brickxter/smartersilo.pcb/kicad-libs/3dmodels/E73-2G4M08S1C.step

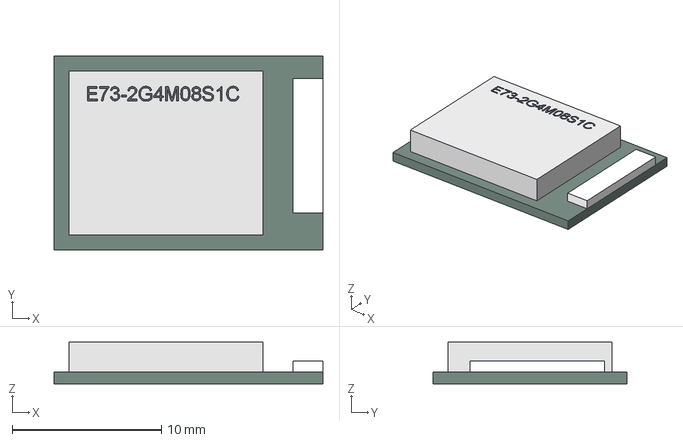
[picture p1: CAD file, 2024-12-10]
kicad-libs/3dmodels/E73-2G4M08S1C.step
18.0 x 13.0 x 2.81 mm
