brickxter/smartersilo.pcb/main-nrf52-e73/v1/main-nrf52-e73.pdf

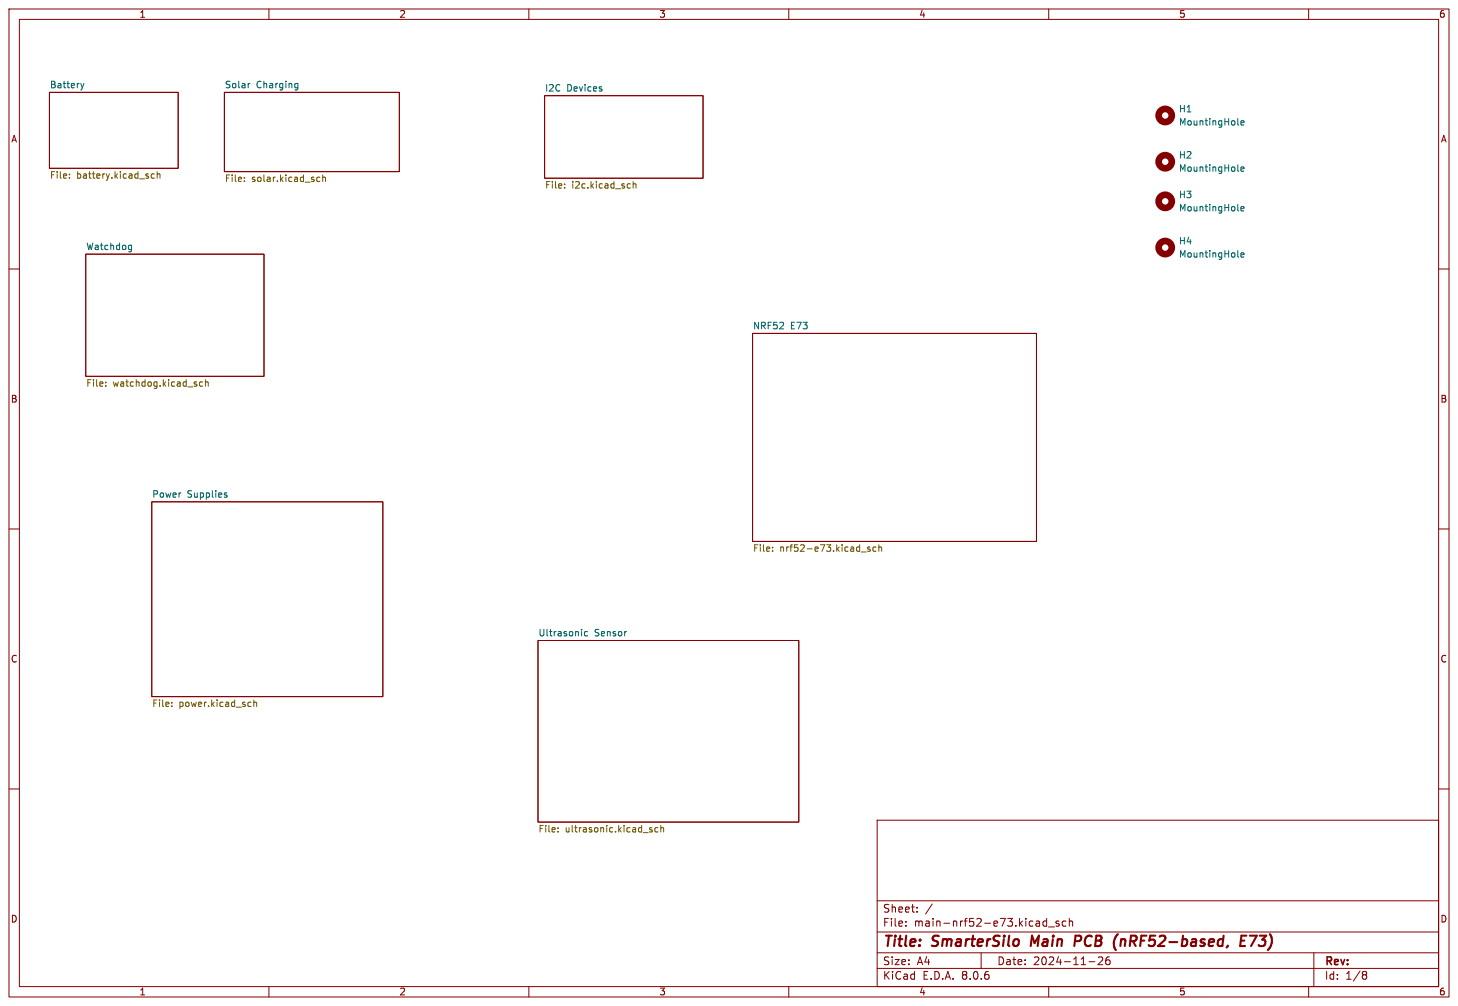
[picture p2: page 1]

Solar Charging File: solar.kicad_sch Battery File: battery.kicad_sch

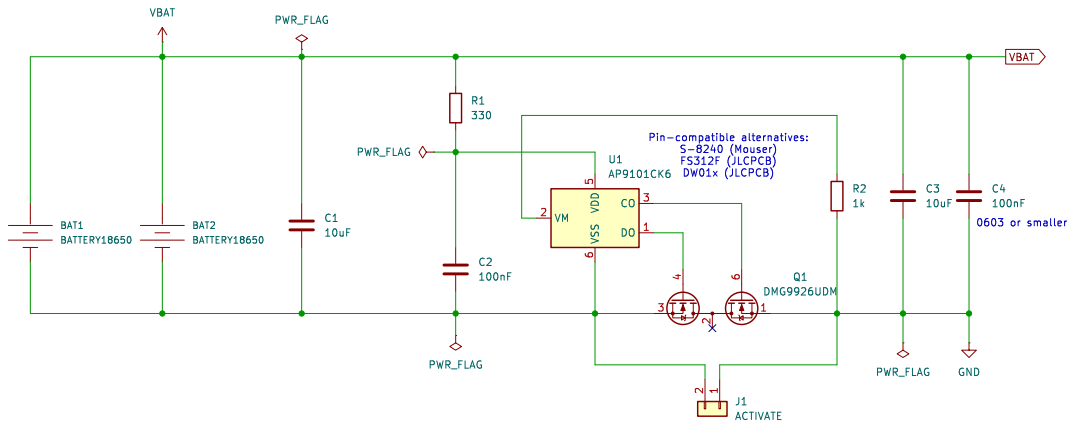
[picture p3: page 2]

Id: 2/8 Title: File: battery.kicad_sch Sheet: /Battery/

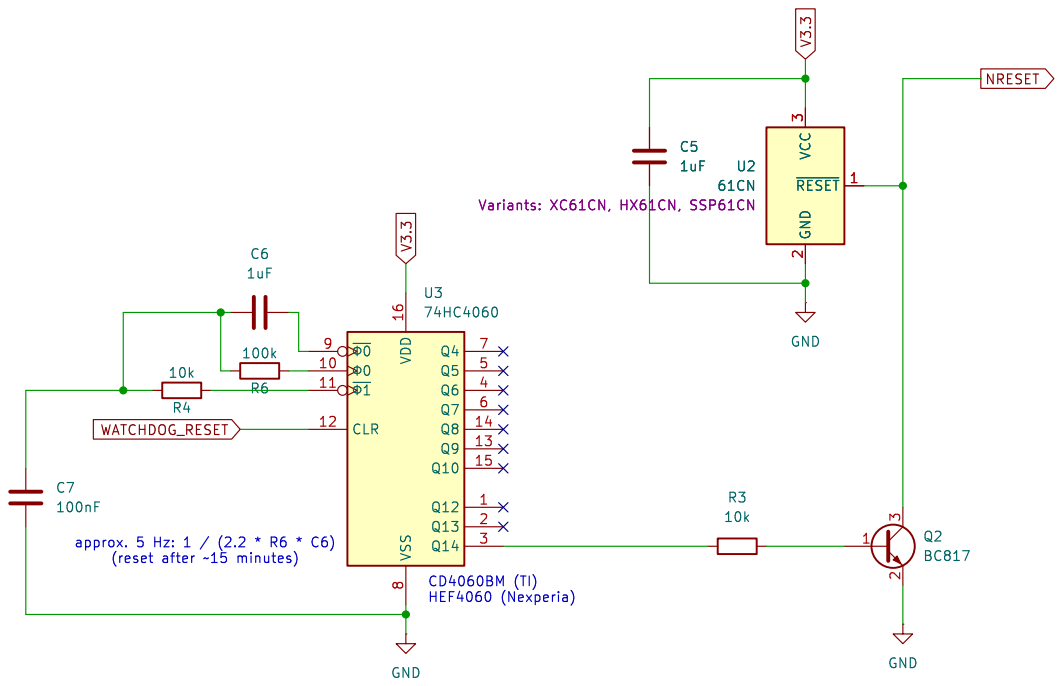
[picture p4: page 3]

File: watchdog.kicad_sch Sheet: /Watchdog/
Id: 3/8 Title: Watchdog Circuits and Voltage Monitoring

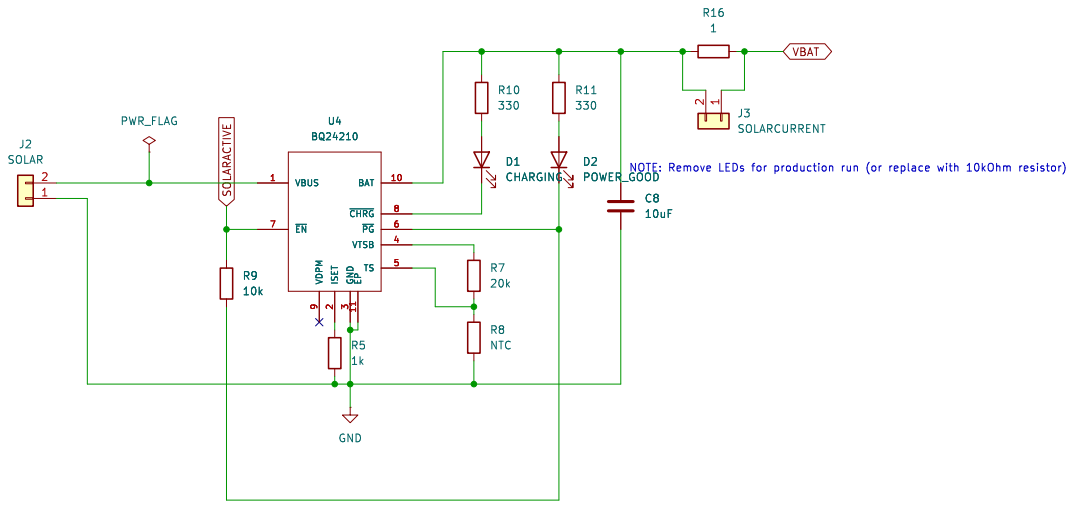
[picture p5: page 4]

3 VTSB 4 TS 5 ~{PG} 6 ~{EN} 7 ~{CHRG} 8 VDPM

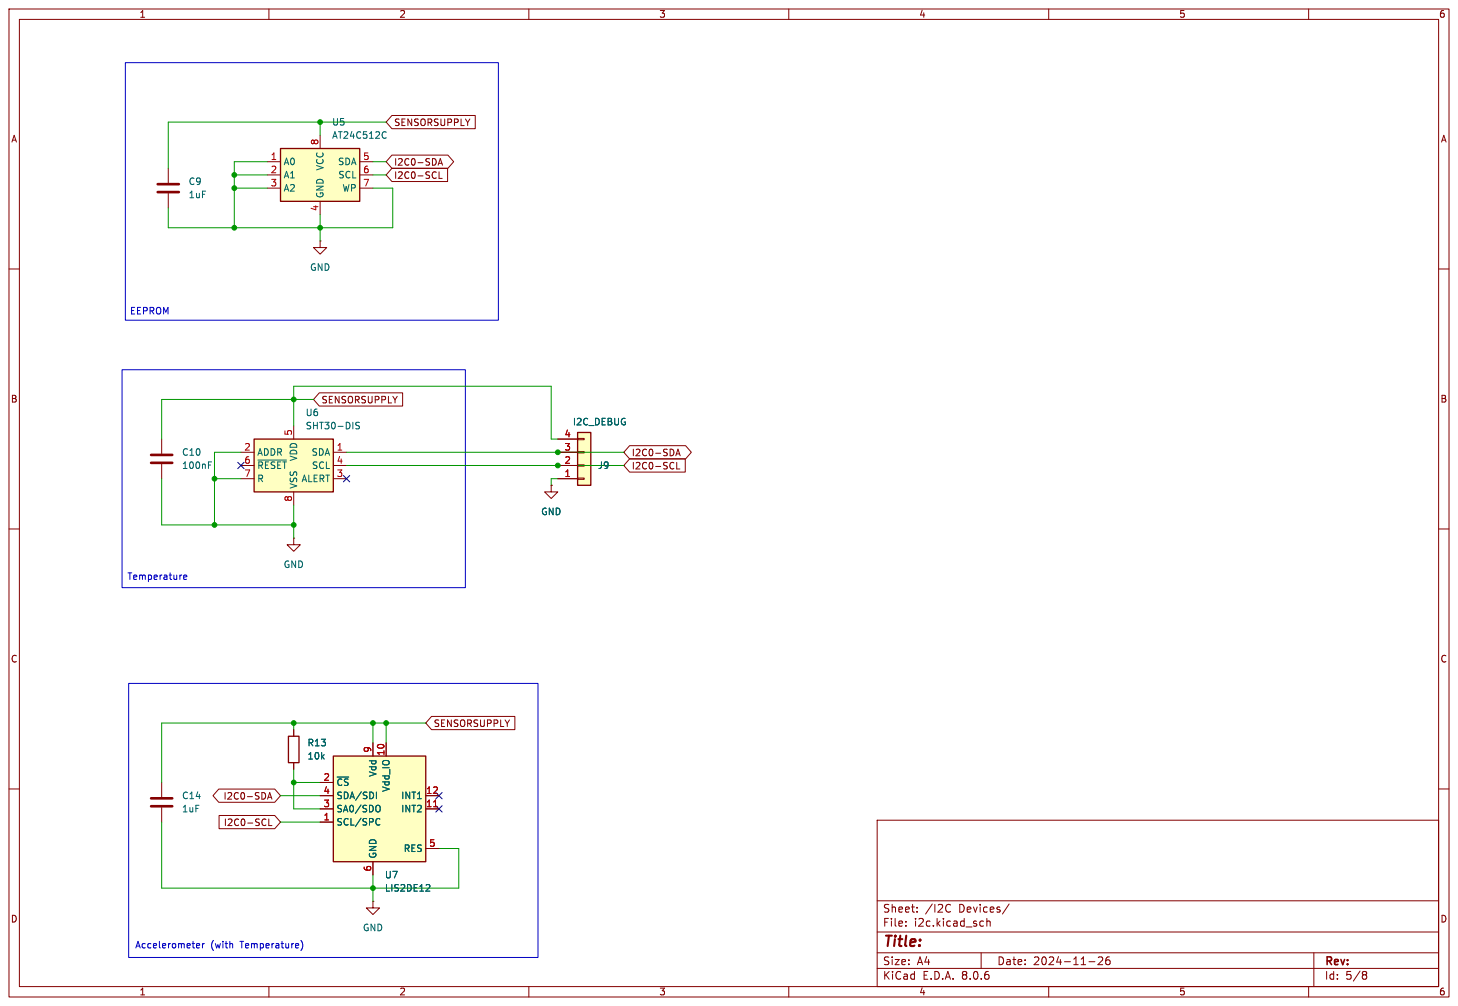
[picture p6: page 5]

4 SDA 5 SCL 6 WP 7 VCC

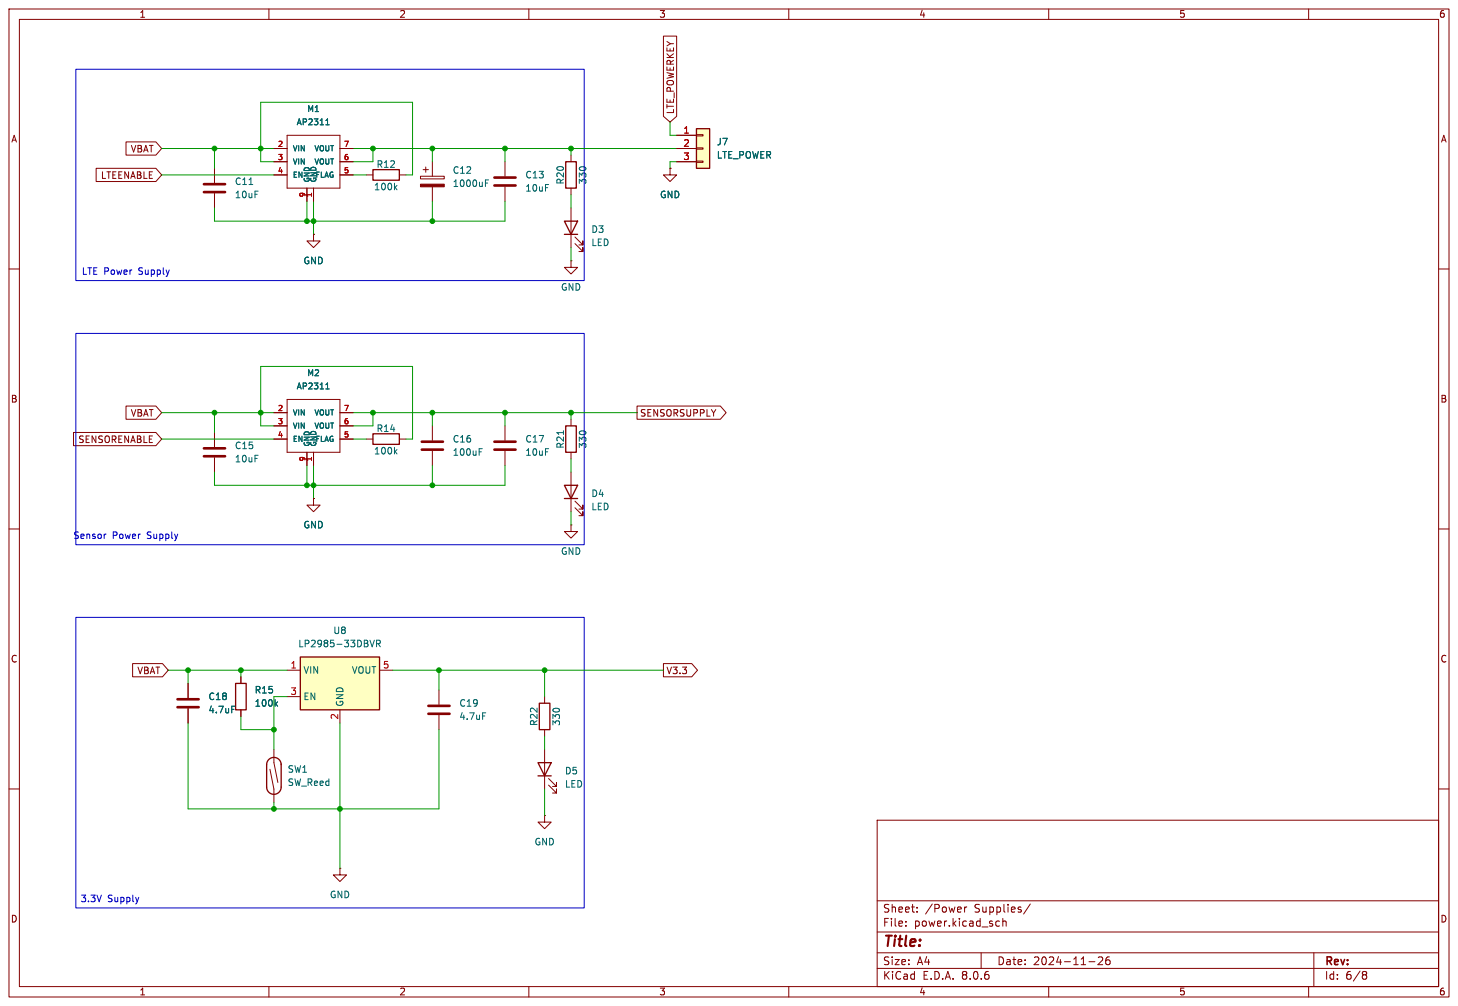
[picture p7: page 6]

1 VIN 2 VIN 3 EN 4 FLAG 5 VOUT 6 VOUT 7 GND
LTE_POWER GND GND
3 GND GND M2 AP2311GND
100k GND
1000uF GND

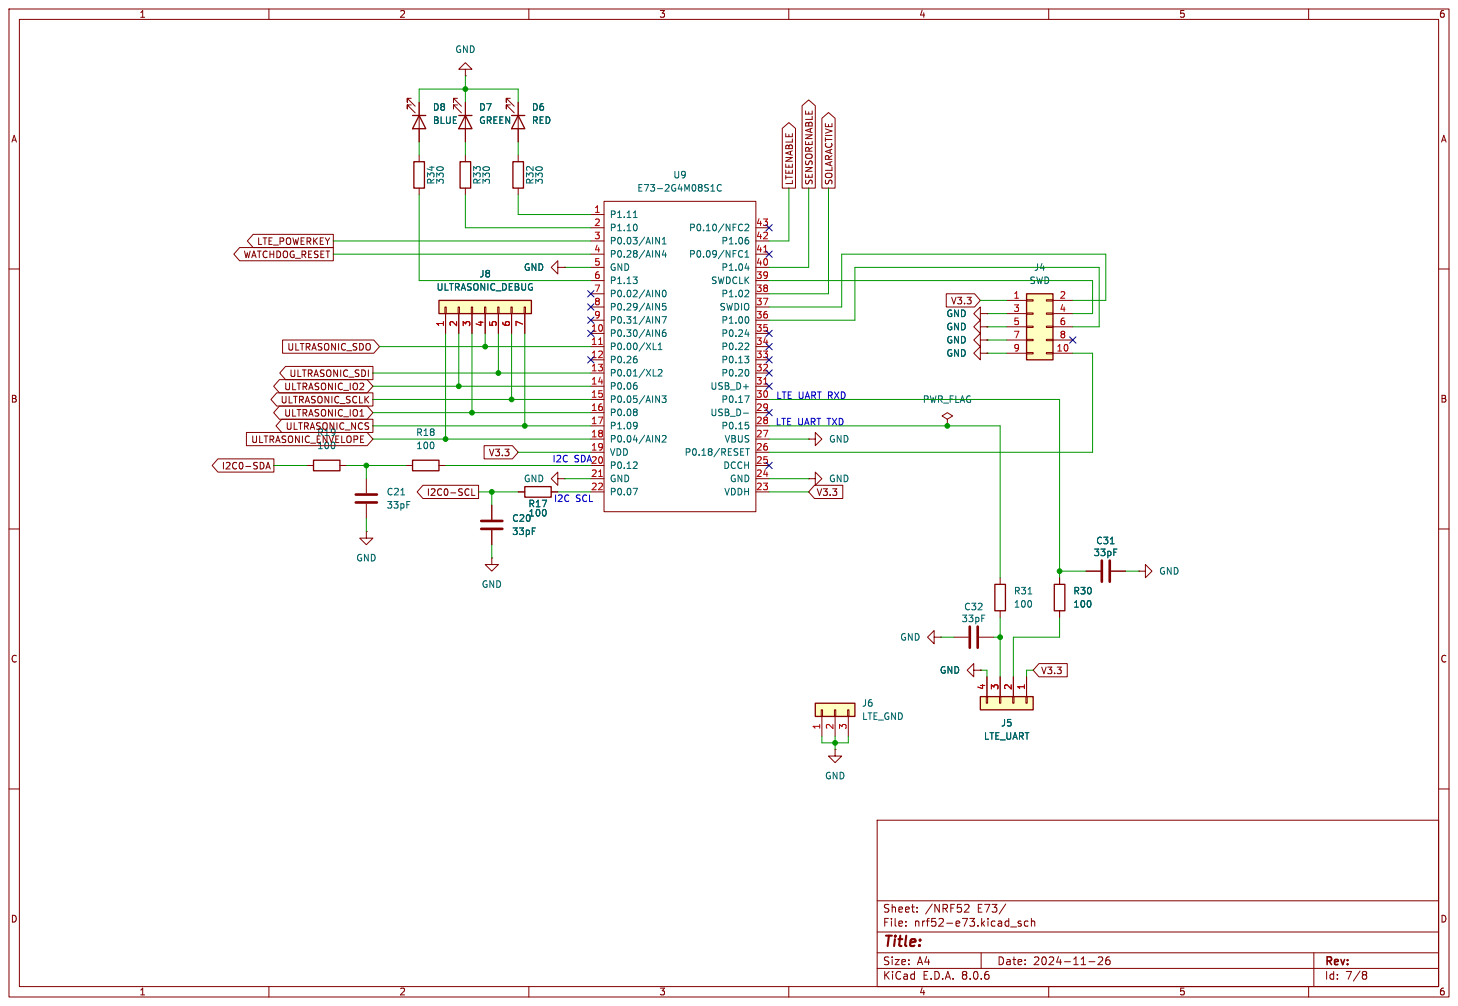
[picture p8: page 7]

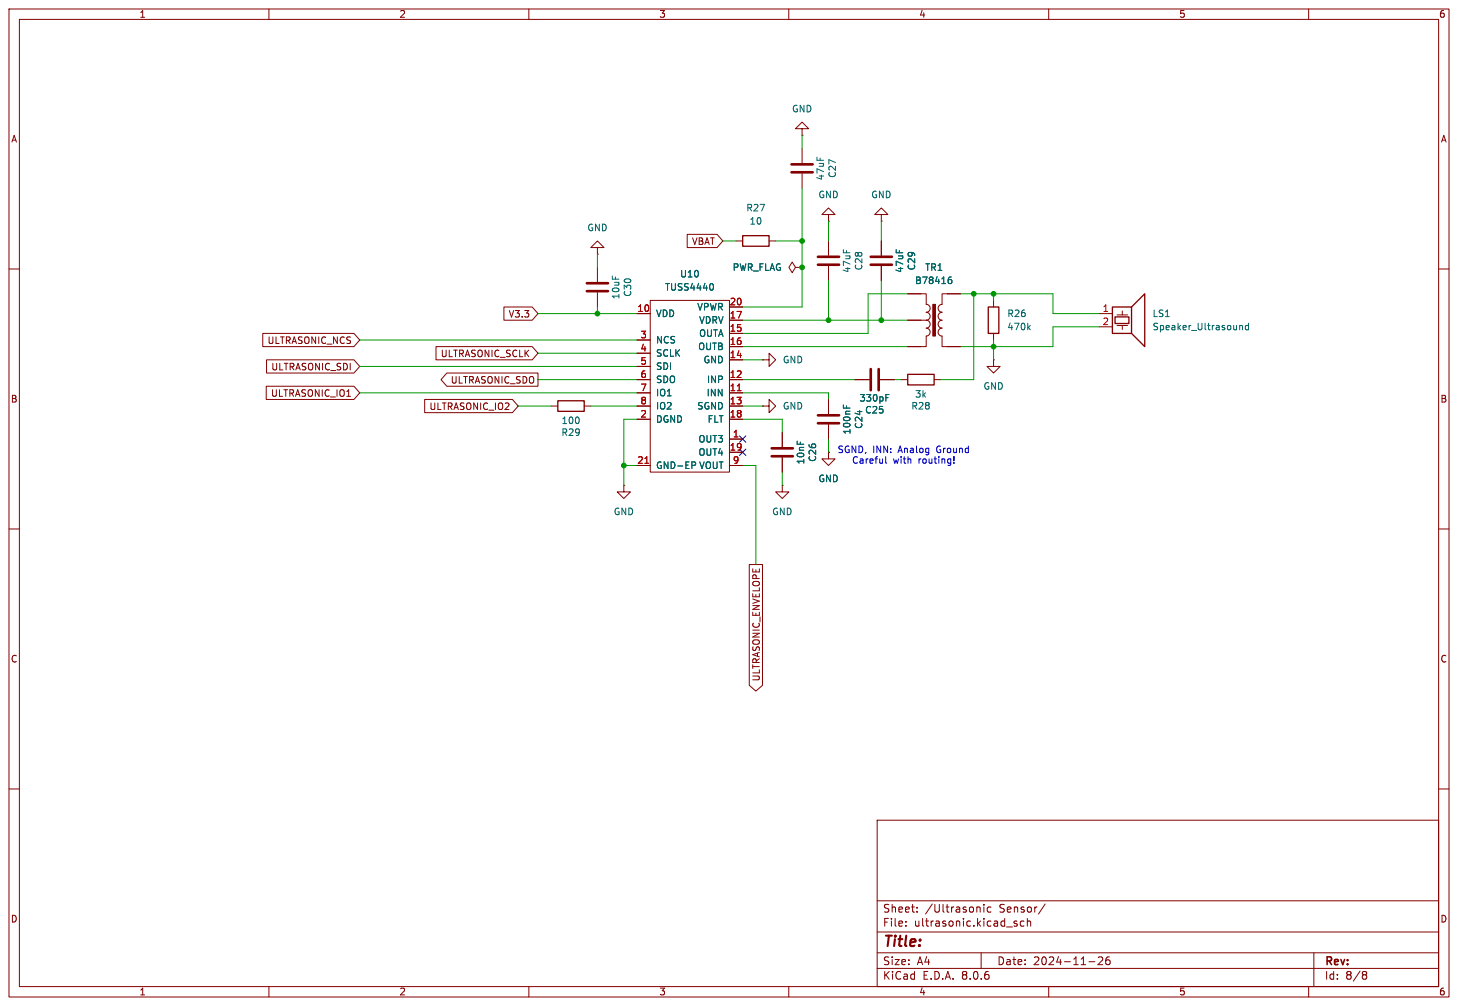
[picture p9: page 8]

SGND, INN: Analog Ground Careful with routing! TR1 B78416 GND 10nF C26 PWR_FLAG
