brickxter/smartersilo.pcb/main-nrf52-e73/main-nrf52-e73.kicad_pcb

## KiCad design main-nrf52-e73/main-nrf52-e73.kicad_pcb (2024-12-10)

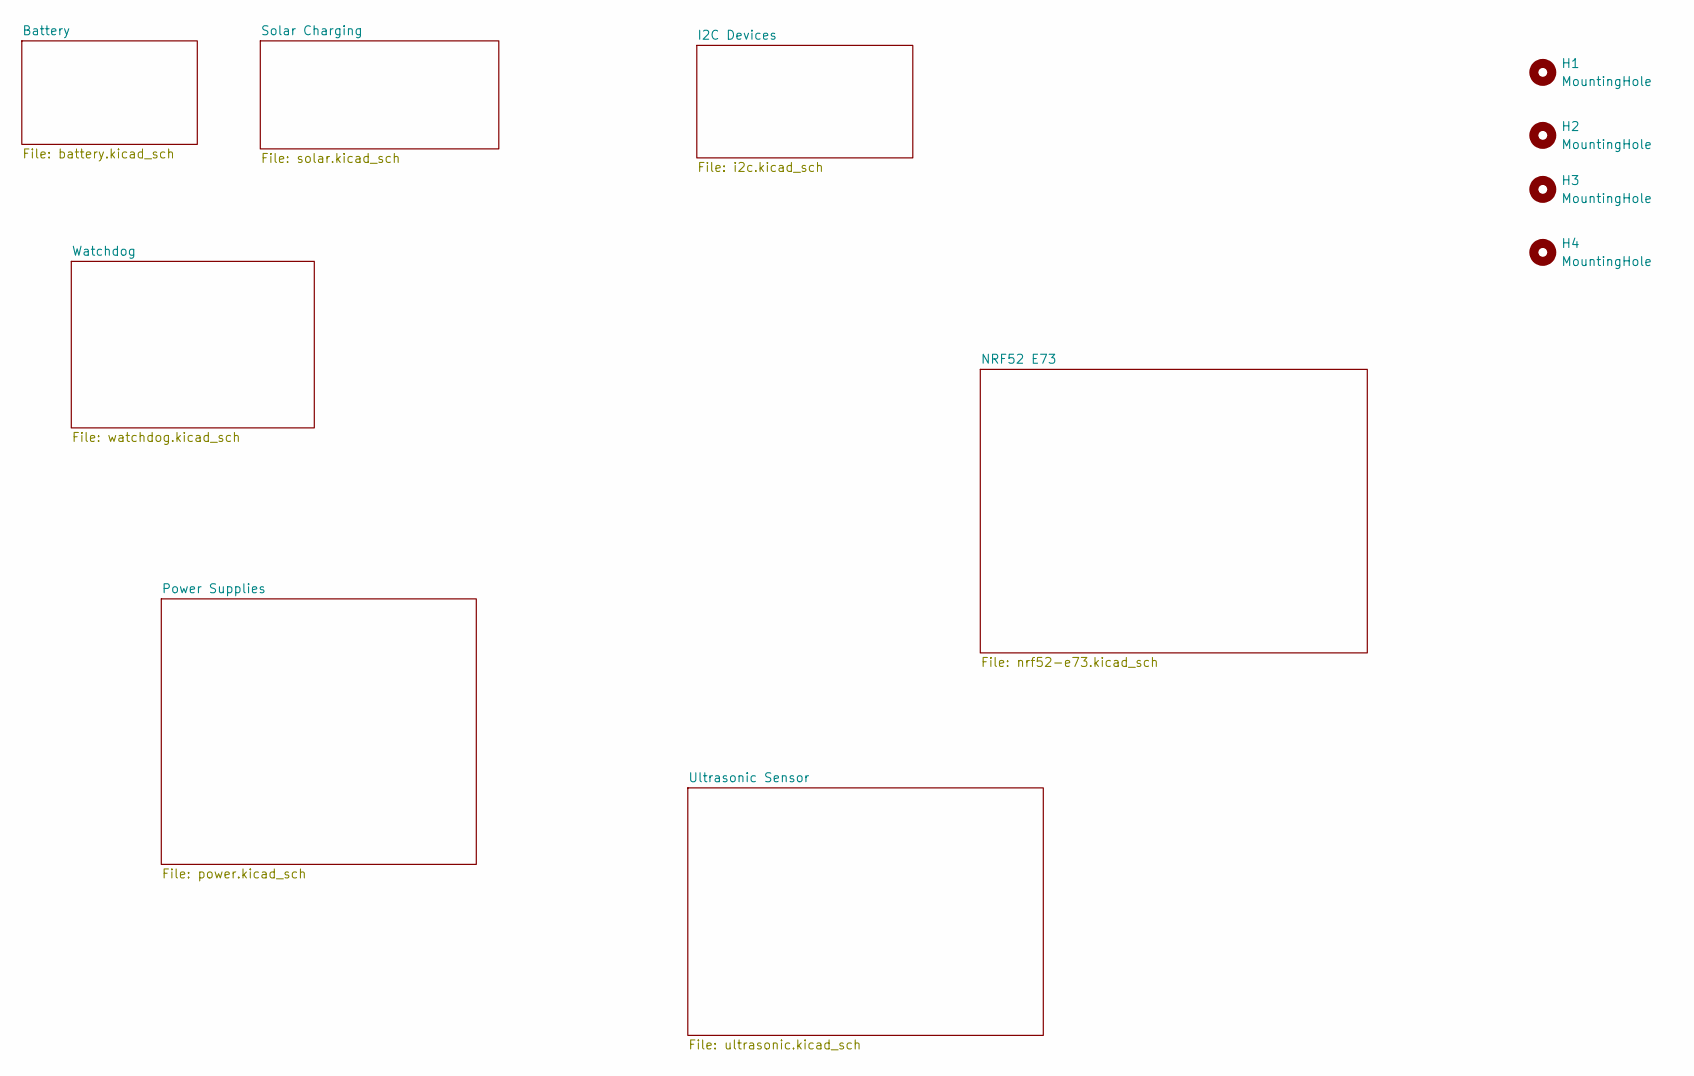
[picture p10: schematic main-nrf52-e73.kicad_sch, SmarterSilo Main PCB (nRF52-based, E73)]

Parts:
H1, H2, H3, H4: MountingHole; MountingHole_3.5mm

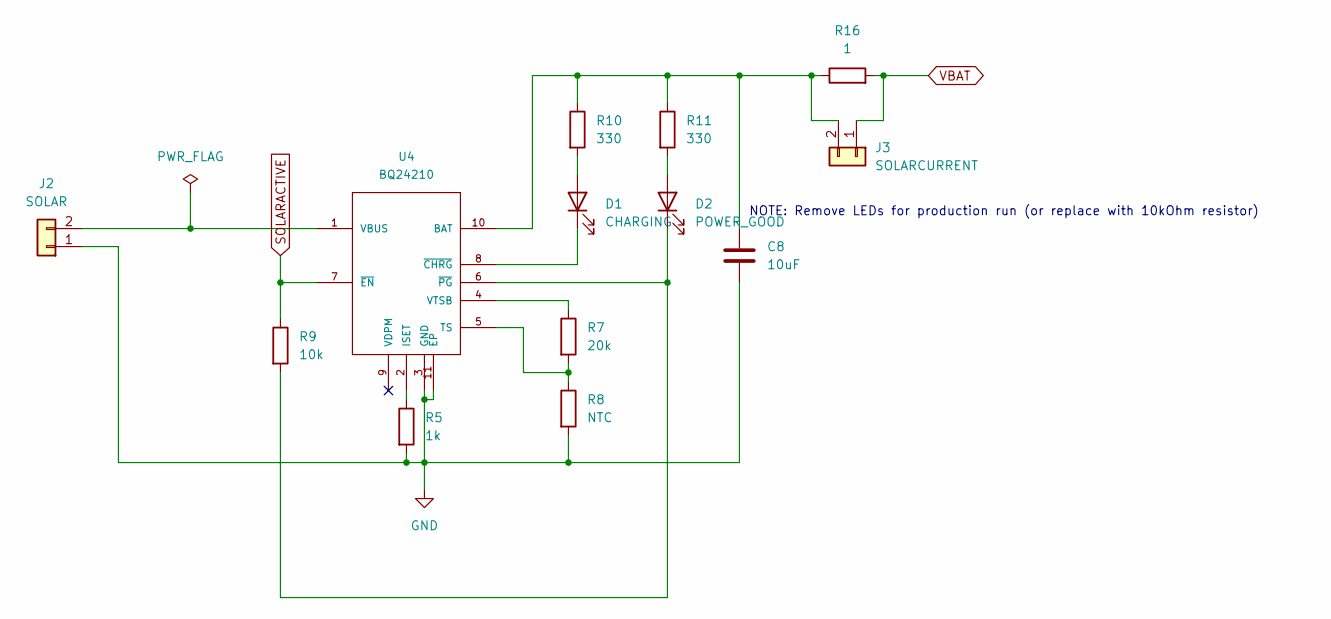
[picture p11: schematic solar.kicad_sch]

Parts:
C8: 10uF; C_0805_2012Metric; LCSC C15850
D1: CHARGING; LED_0603_1608Metric; LCSC C2286
D2: POWER_GOOD; LED_0603_1608Metric; LCSC C2286
J2: SOLAR; PinHeader_1x02_P2.54mm_Vertical
J3: SOLARCURRENT; PinHeader_1x02_P2.54mm_Vertical
R5: 1k; R_0603_1608Metric; LCSC C21190
R7: 20k; R_0603_1608Metric; LCSC C4184
R8: NTC; R_0603_1608Metric; LCSC C76589
R9: 10k; R_0603_1608Metric; LCSC C25804
R10, R11: 330; R_0603_1608Metric; LCSC C23138
R16: 1; R_0603_1608Metric; LCSC C22936
U4: BQ24210; WSON-10-1EP_2.5x2.5mm_P0.5mm_EP1.2x2mm; LCSC C524795

Connections:
GND: C8.2, J2.1, R5.2, R8.2, U4.3 (GND), U4.11 (EP); also elsewhere on the board
unnamed: D1.2 (A), R10.2
unnamed: D1.1 (K), U4.8 (~CHRG)
unnamed: D2.2 (A), R11.2
unnamed: D2.1 (K), R9.2, U4.6 (~PG)
unnamed: J2.2, U4.1 (VBUS)
unnamed: C8.1, J3.2, R10.1, R11.1, R16.1, U4.10 (BAT)
unnamed: R5.1, U4.2 (ISET)
unnamed: R7.2, R8.1, U4.5 (TS)
unnamed: R7.1, U4.4 (VTSB)
SOLARACTIVE: R9.1, U4.7 (~EN); also elsewhere on the board
VBAT: J3.1, R16.2; also elsewhere on the board

Notes on the sheet:
NOTE: Remove LEDs for production run (or replace with 10kOhm resistor)

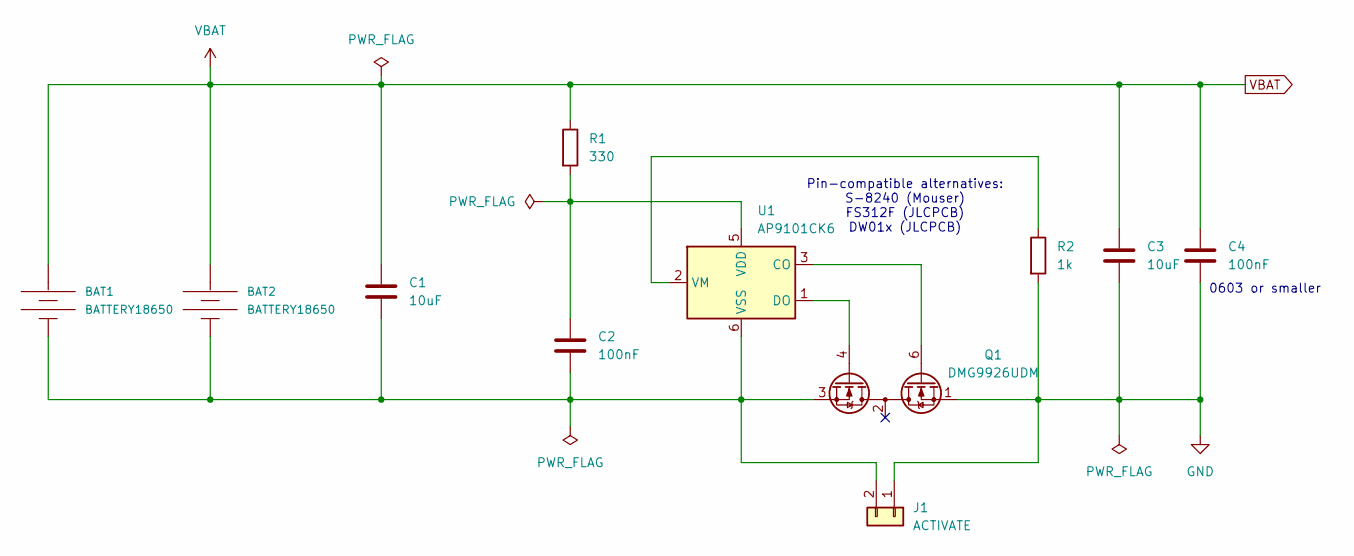
[picture p12: schematic battery.kicad_sch]

Parts:
BAT1, BAT2: BATTERY18650; MyParts-BATTERY_18650-HOLDER
C1, C3: 10uF; C_0805_2012Metric; LCSC C15850
C2, C4: 100nF; C_0603_1608Metric; LCSC C14663
J1: ACTIVATE; PinHeader_1x02_P2.54mm_Vertical
Q1: DMG9926UDM; SOT-23-6; LCSC C156289
R1: 330; R_0603_1608Metric; LCSC C23138
R2: 1k; R_0603_1608Metric; LCSC C21190
U1: AP9101CK6; SOT-23-6; LCSC C151339

Connections:
GND: C3.2, C4.2, J1.1, Q1.1 (D1), R2.2; also elsewhere on the board
unnamed: BAT1.GND@ (-), BAT2.GND@ (-), C1.2, C2.2, J1.2, Q1.3 (S2), U1.6 (VSS)
unnamed: Q1.6 (G1), U1.3 (CO)
unnamed: Q1.4 (G2), U1.1 (DO)
unnamed: C2.1, R1.2, U1.5 (VDD)
unnamed: R2.1, U1.2 (VM)
VBAT: BAT1.PWR@ (+), BAT2.PWR@ (+), C1.1, C3.1, C4.1, R1.1; also elsewhere on the board

Notes on the sheet:
0603 or smaller
Pin-compatible alternatives: S-8240 (Mouser) FS312F (JLCPCB) DW01x (JLCPCB)

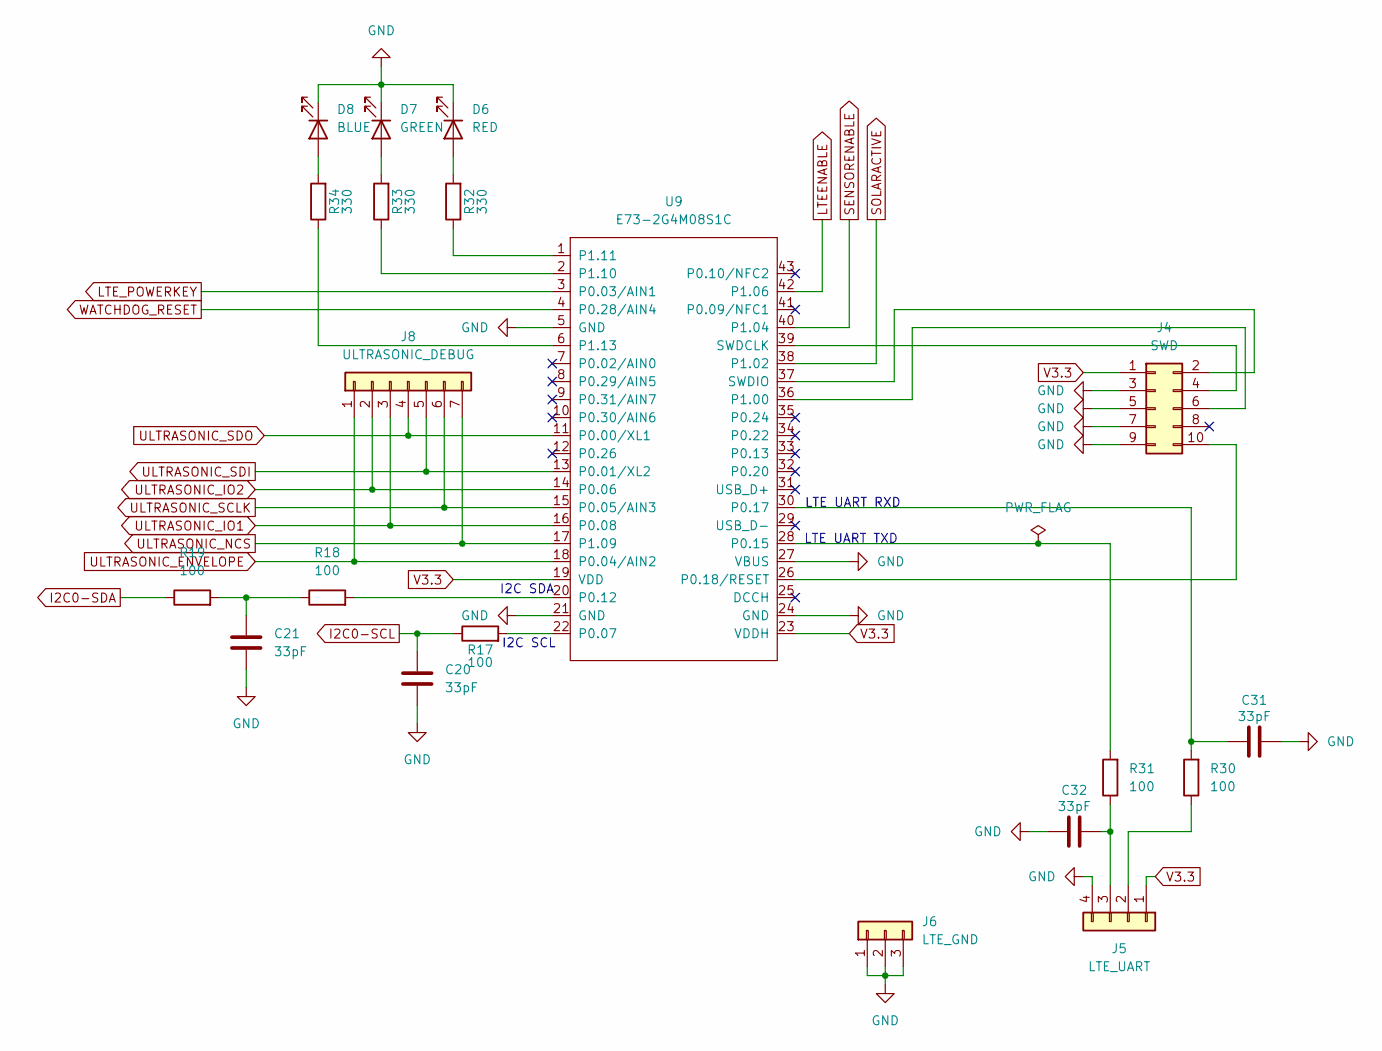
[picture p13: schematic nrf52-e73.kicad_sch]

Parts:
C20, C21, C31, C32: 33pF; C_0603_1608Metric; LCSC C1663
D6: RED; LED_0603_1608Metric; LCSC C2286
D7: GREEN; LED_0603_1608Metric; LCSC C12624
D8: BLUE; LED_0603_1608Metric; LCSC C2288
J4: SWD; PinHeader_2x05_P1.27mm_Vertical_SMD
J5: LTE_UART; PinHeader_1x04_P2.54mm_Vertical
J6: LTE_GND; PinHeader_1x03_P2.54mm_Vertical
J8: ULTRASONIC_DEBUG; PinHeader_1x07_P2.54mm_Vertical
R17, R18, R19, R30, R31: 100; R_0603_1608Metric; LCSC C22775
R32, R33, R34: 330; R_0603_1608Metric; LCSC C23138
U9: E73-2G4M08S1C; E73(2G4M08S1C); LCSC C356849

Connections:
GND: C20.2, C21.2, C31.2, C32.1, D6.1 (K), D7.1 (K), D8.1 (K), J4.3, J4.5, J4.7, J4.9, J5.4, J6.1, J6.2, J6.3, U9.5 (GND), U9.21 (GND), U9.24 (GND), U9.27 (VBUS); also elsewhere on the board
I2C0-SCL: C20.1, R17.1; also elsewhere on the board
I2C0-SDA: R19.1; also elsewhere on the board
LTEENABLE: U9.42 (P1.06); also elsewhere on the board
LTE_POWERKEY: U9.3 (P0.03/AIN1); also elsewhere on the board
unnamed: C21.1, R18.1, R19.2
unnamed: D6.2 (A), R32.2
unnamed: D7.2 (A), R33.2
unnamed: D8.2 (A), R34.2
unnamed: J4.2, U9.37 (SWDIO)
unnamed: J4.4, U9.39 (SWDCLK)
unnamed: J4.6, U9.36 (P1.00)
unnamed: J4.10, U9.26 (P0.18/RESET)
unnamed: J5.2, R30.1
unnamed: C32.2, J5.3, R31.1
unnamed: R17.2, U9.22 (P0.07)
unnamed: R18.2, U9.20 (P0.12)
unnamed: R31.2, U9.28 (P0.15)
unnamed: C31.1, R30.2, U9.30 (P0.17)
unnamed: R33.1, U9.2 (P1.10)
unnamed: R32.1, U9.1 (P1.11)
unnamed: R34.1, U9.6 (P1.13)
SENSORENABLE: U9.40 (P1.04); also elsewhere on the board
SOLARACTIVE: U9.38 (P1.02); also elsewhere on the board
ULTRASONIC_ENVELOPE: J8.1, U9.18 (P0.04/AIN2); also elsewhere on the board
ULTRASONIC_IO1: J8.3, U9.16 (P0.08); also elsewhere on the board
ULTRASONIC_IO2: J8.2, U9.14 (P0.06); also elsewhere on the board
ULTRASONIC_NCS: J8.7, U9.17 (P1.09); also elsewhere on the board
ULTRASONIC_SCLK: J8.6, U9.15 (P0.05/AIN3); also elsewhere on the board
ULTRASONIC_SDI: J8.5, U9.13 (P0.01/XL2); also elsewhere on the board
ULTRASONIC_SDO: J8.4, U9.11 (P0.00/XL1); also elsewhere on the board
V3.3: J4.1, J5.1, U9.19 (VDD), U9.23 (VDDH); also elsewhere on the board
WATCHDOG_RESET: U9.4 (P0.28/AIN4); also elsewhere on the board

Notes on the sheet:
I2C SDA
I2C SCL
LTE UART TXD
LTE UART RXD

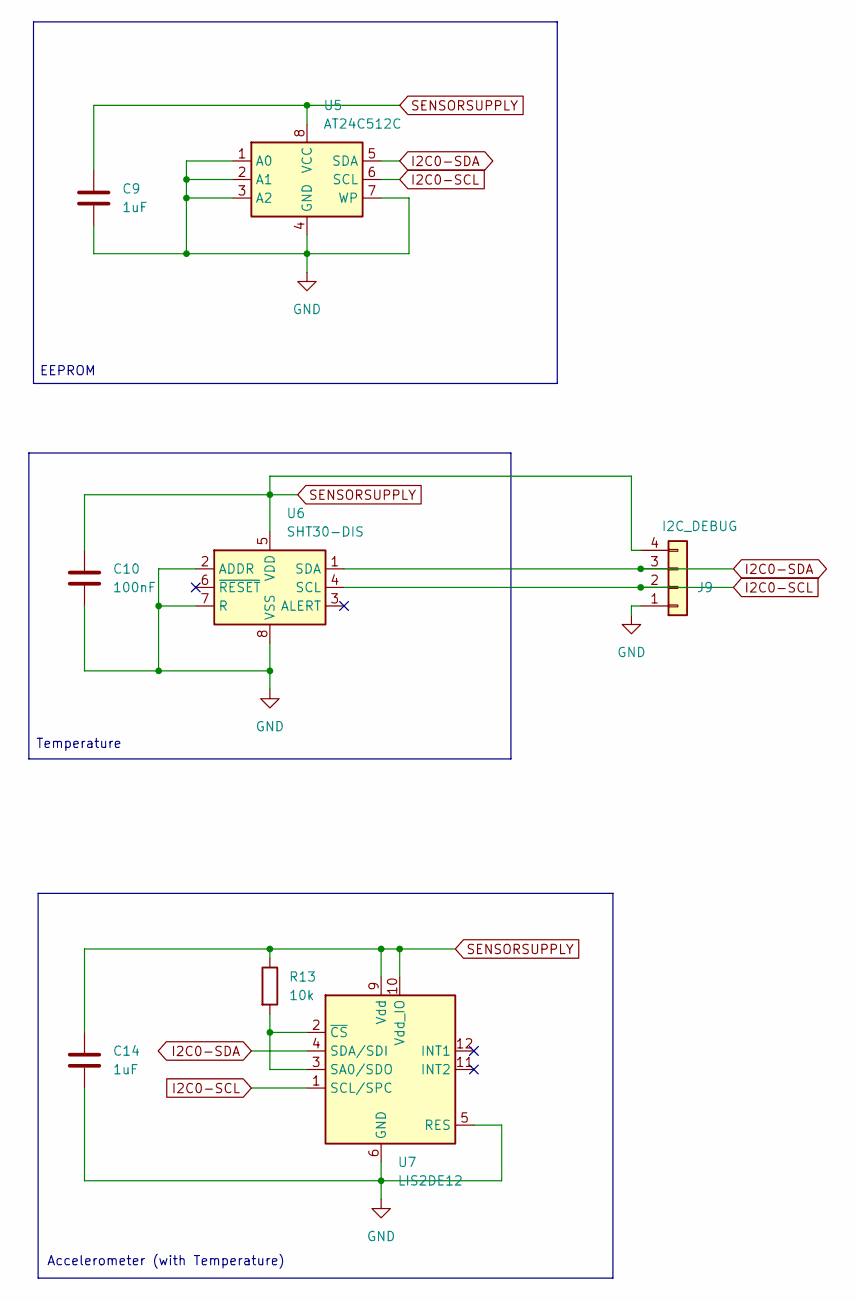
[picture p14: schematic i2c.kicad_sch]

Parts:
C9, C14: 1uF; C_0805_2012Metric; LCSC C28323
C10: 100nF; C_0603_1608Metric; LCSC C14663
J9: I2C_DEBUG; PinHeader_1x04_P2.54mm_Vertical
R13: 10k; R_0603_1608Metric; LCSC C25804
U5: AT24C512C; SOIC-8_3.9x4.9mm_P1.27mm; LCSC C12371
U6: SHT30-DIS; Sensirion_DFN-8-1EP_2.5x2.5mm_P0.5mm_EP1.1x1.7mm; LCSC C77361
U7: LIS2DE12; LGA-12_2x2mm_P0.5mm; LCSC C110926

Connections:
GND: C9.2, C10.2, C14.2, J9.1, U5.1 (A0), U5.2 (A1), U5.3 (A2), U5.4 (GND), U5.7 (WP), U6.2 (ADDR), U6.7 (R), U6.8 (VSS), U6.9 (VSS), U7.5 (RES), U7.6 (GND), U7.7 (GND), U7.8 (GND); also elsewhere on the board
I2C0-SCL: J9.2, U5.6 (SCL), U6.4 (SCL), U7.1 (SCL/SPC); also elsewhere on the board
I2C0-SDA: J9.3, U5.5 (SDA), U6.1 (SDA), U7.4 (SDA/SDI); also elsewhere on the board
unnamed: R13.2, U7.2 (~CS), U7.3 (SA0/SDO)
SENSORSUPPLY: C9.1, C10.1, C14.1, J9.4, R13.1, U5.8 (VCC), U6.5 (VDD), U7.9 (Vdd), U7.10 (Vdd_IO); also elsewhere on the board

Notes on the sheet:
EEPROM
Temperature
Accelerometer (with Temperature)

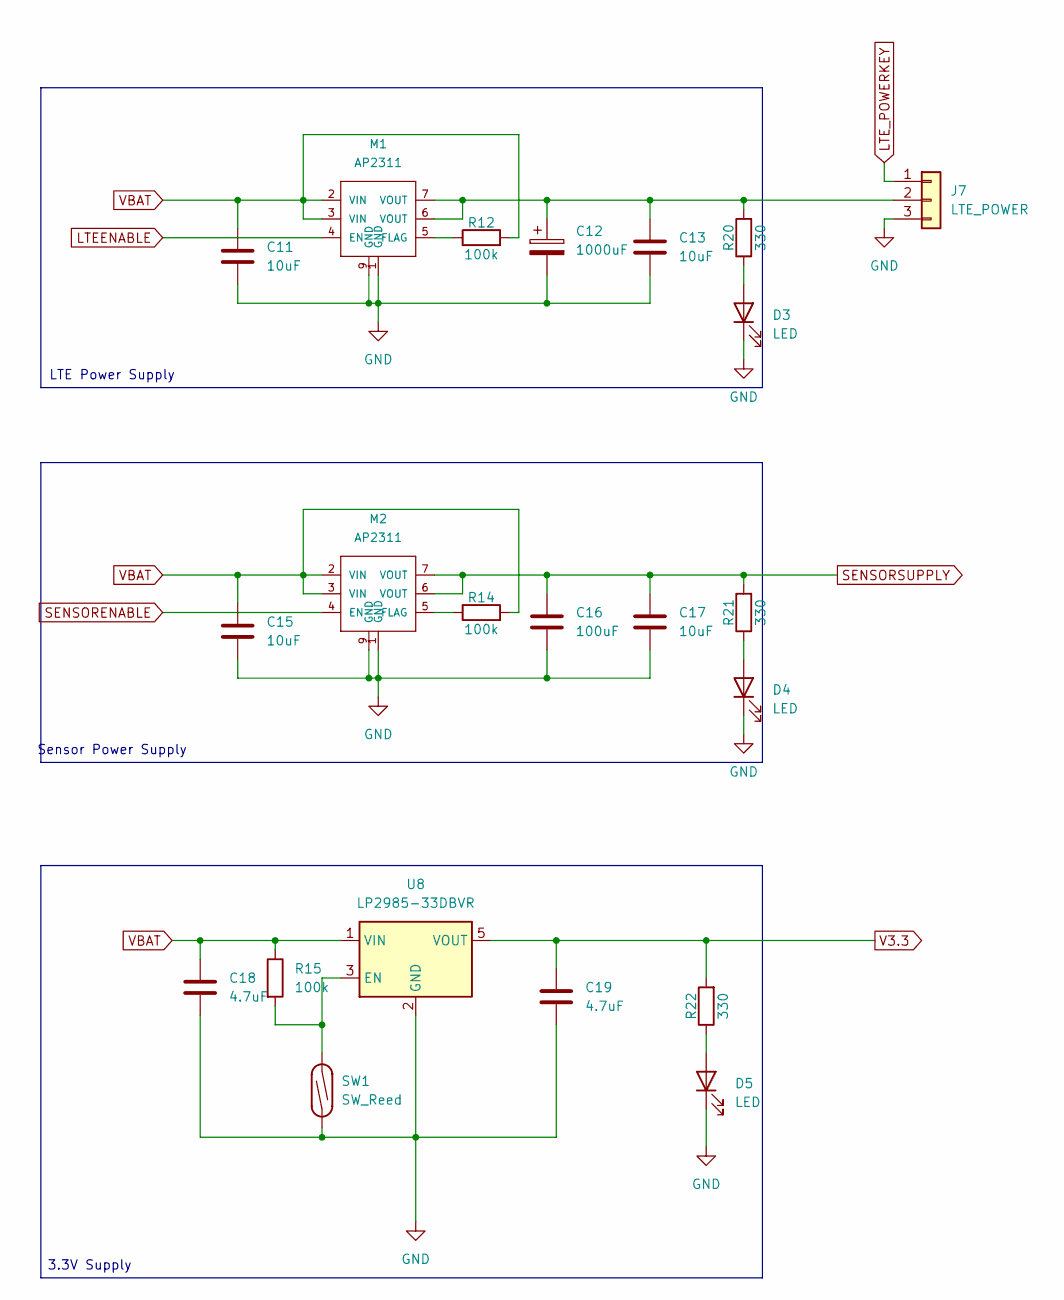
[picture p15: schematic power.kicad_sch]

Parts:
C11, C13, C15, C17: 10uF; C_0805_2012Metric; LCSC C15850
C12: 1000uF; CP_Elec_10x10.5; LCSC C263979
C16: 100uF; C_1206_3216Metric; LCSC C15008
C18, C19: 4.7uF; C_0805_2012Metric; LCSC C1779
D3, D4, D5: LED; LED_0603_1608Metric; LCSC C2286
J7: LTE_POWER; PinHeader_1x03_P2.54mm_Vertical
M1, M2: AP2311; MSOP-8-1EP_3x3mm_P0.65mm_EP1.68x1.88mm; LCSC C460351
R12, R14, R15: 100k; R_0603_1608Metric; LCSC C25803
R20, R21, R22: 330; R_0603_1608Metric; LCSC C23138
SW1: SW_Reed; SW_SPST_REED_CT10-XXXX-G1
U8: LP2985-33DBVR; SOT-23-5; LCSC C95414

Connections:
GND: C11.2, C12.2, C13.2, C15.2, C16.2, C17.2, C18.2, C19.2, D3.1 (K), D4.1 (K), D5.1 (K), J7.3, M1.1 (GND), M1.9 (GND), M2.1 (GND), M2.9 (GND), SW1.1, U8.2 (GND); also elsewhere on the board
LTEENABLE: M1.4 (EN); also elsewhere on the board
LTE_POWERKEY: J7.1; also elsewhere on the board
unnamed: D3.2 (A), R20.1
unnamed: D4.2 (A), R21.1
unnamed: D5.2 (A), R22.1
unnamed: C12.1, C13.1, J7.2, M1.6 (VOUT), M1.7 (VOUT), R20.2
unnamed: M1.5 (FLAG), R12.1
unnamed: M2.5 (FLAG), R14.1
unnamed: R15.2, SW1.2, U8.3 (EN)
SENSORENABLE: M2.4 (EN); also elsewhere on the board
SENSORSUPPLY: C16.1, C17.1, M2.6 (VOUT), M2.7 (VOUT), R21.2; also elsewhere on the board
V3.3: C19.1, R22.2, U8.5 (VOUT); also elsewhere on the board
VBAT: C11.1, C15.1, C18.1, M1.2 (VIN), M1.3 (VIN), M2.2 (VIN), M2.3 (VIN), R12.2, R14.2, R15.1, U8.1 (VIN); also elsewhere on the board

Notes on the sheet:
Sensor Power Supply
3.3V Supply
LTE Power Supply

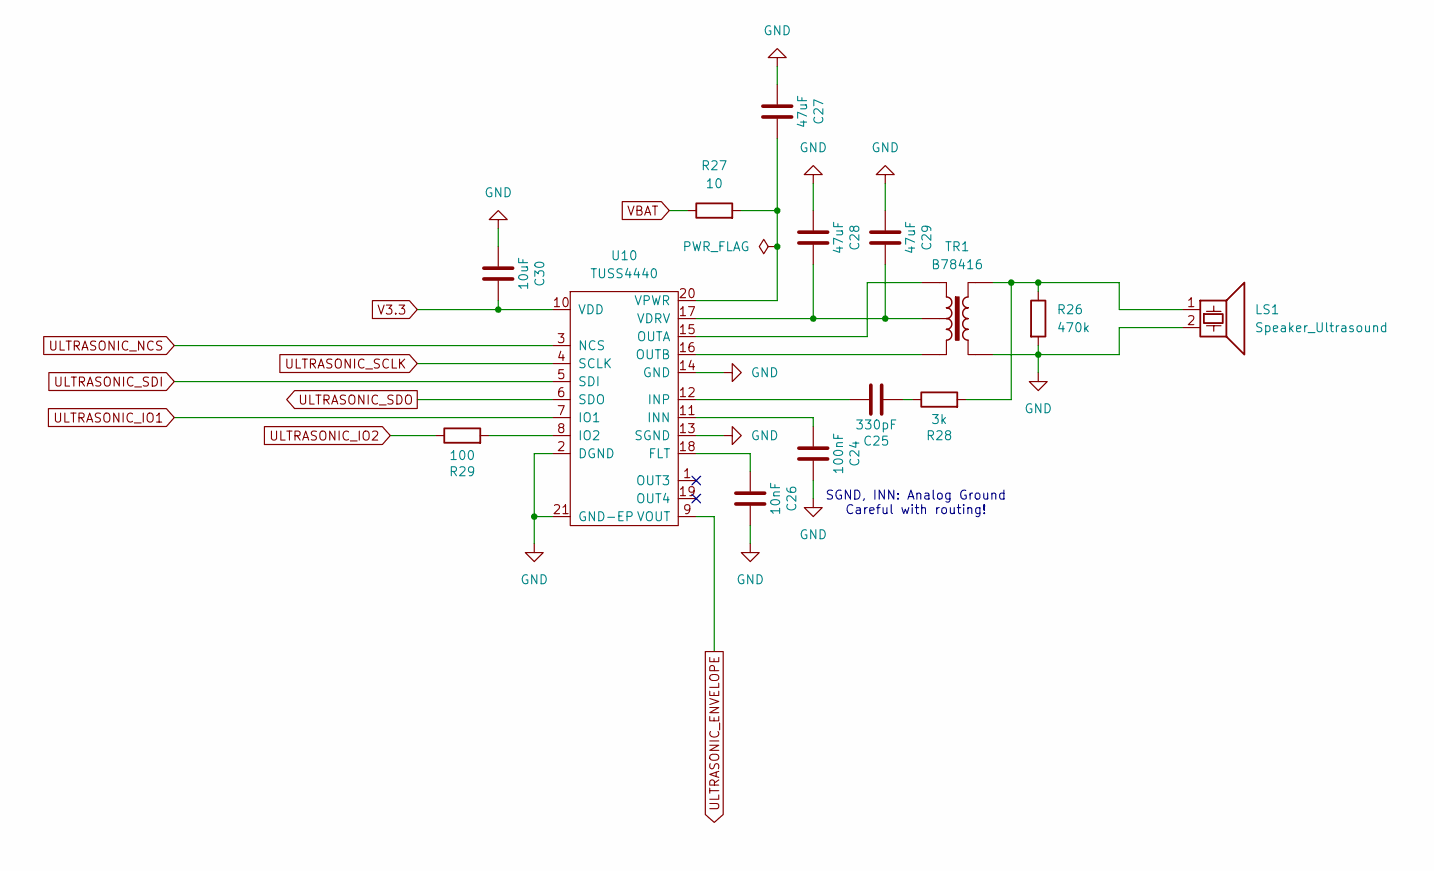
[picture p16: schematic ultrasonic.kicad_sch]

Parts:
C24: 100nF; C_0603_1608Metric; LCSC C14663
C25: 330pF; C_0603_1608Metric; LCSC C1664
C26: 10nF; C_0603_1608Metric; LCSC C57112
C27, C28, C29: 47uF; C_1206_3216Metric; LCSC C96123
C30: 10uF; C_0805_2012Metric; LCSC C15850
LS1: Speaker_Ultrasound; 400EP250-Holes
R26: 470k; R_0603_1608Metric; LCSC C23178
R27: 10; R_0603_1608Metric; LCSC C22859
R28: 3k; R_0603_1608Metric; LCSC C4211
R29: 100; R_0603_1608Metric; LCSC C22775
TR1: B78416
U10: TUSS4440; QFN-20-1EP_4x4mm_P0.5mm_EP2.6x2.6mm; LCSC C1855778

Connections:
GND: C24.2, C26.2, C27.1, C28.1, C29.1, C30.1, LS1.2, R26.2, TR1.4, U10.2 (DGND), U10.13 (SGND), U10.14 (GND), U10.21 (GND-EP); also elsewhere on the board
unnamed: C25.1, R28.1
unnamed: LS1.1, R26.1, R28.2, TR1.5
unnamed: C26.1, U10.18 (FLT)
unnamed: C24.1, U10.11 (INN)
unnamed: C25.2, U10.12 (INP)
unnamed: R29.2, U10.8 (IO2)
unnamed: TR1.1, U10.15 (OUTA)
unnamed: TR1.3, U10.16 (OUTB)
unnamed: C28.2, C29.2, TR1.2, U10.17 (VDRV)
unnamed: C27.2, R27.2, U10.20 (VPWR)
ULTRASONIC_ENVELOPE: U10.9 (VOUT); also elsewhere on the board
ULTRASONIC_IO1: U10.7 (IO1); also elsewhere on the board
ULTRASONIC_IO2: R29.1; also elsewhere on the board
ULTRASONIC_NCS: U10.3 (NCS); also elsewhere on the board
ULTRASONIC_SCLK: U10.4 (SCLK); also elsewhere on the board
ULTRASONIC_SDI: U10.5 (SDI); also elsewhere on the board
ULTRASONIC_SDO: U10.6 (SDO); also elsewhere on the board
V3.3: C30.2, U10.10 (VDD); also elsewhere on the board
VBAT: R27.1; also elsewhere on the board

Notes on the sheet:
SGND, INN: Analog Ground Careful with routing!

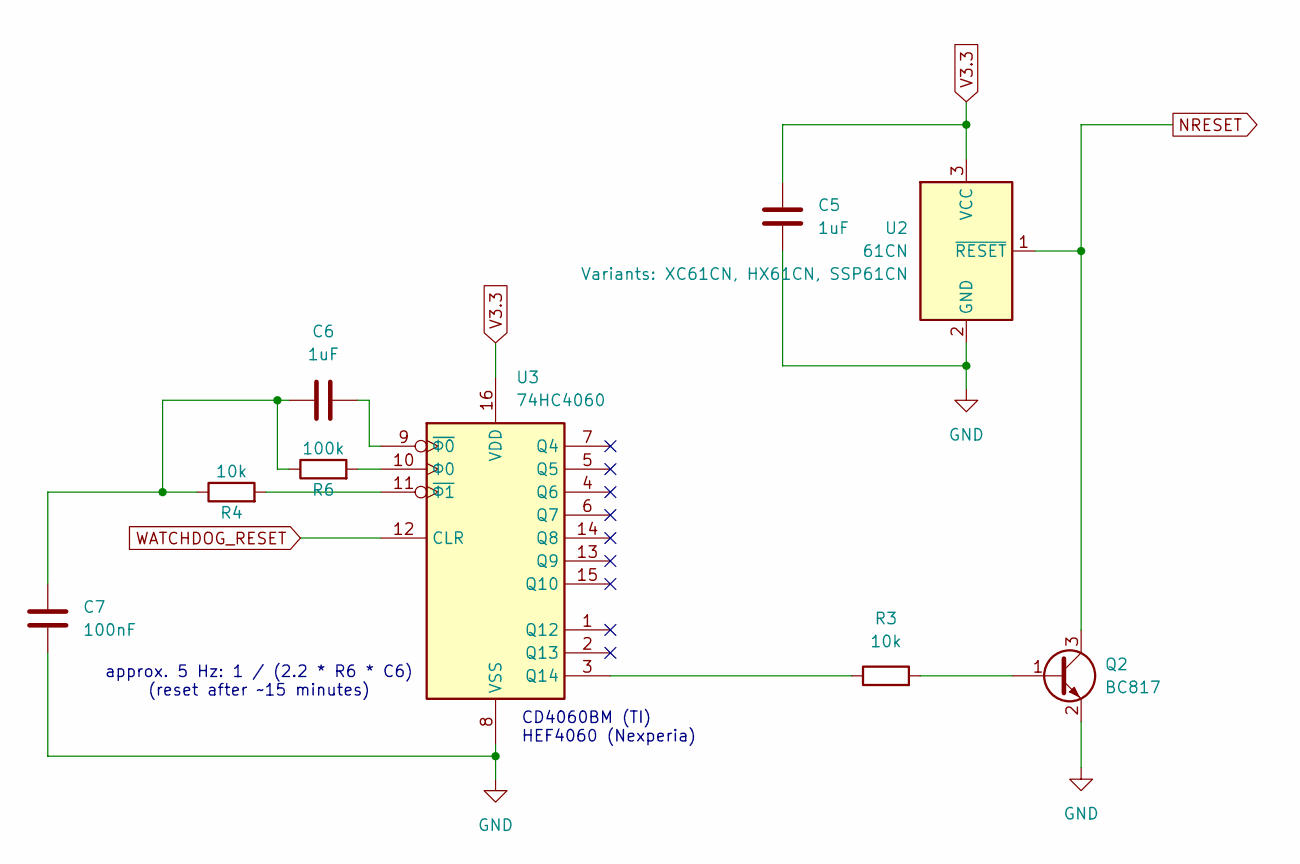
[picture p17: schematic watchdog.kicad_sch, Watchdog Circuits and Voltage Monitoring]

Parts:
C5, C6: 1uF; C_0805_2012Metric; LCSC C28323
C7: 100nF; C_0603_1608Metric; LCSC C14663
Q2: BC817; SOT-23; LCSC C444722
R3, R4: 10k; R_0603_1608Metric; LCSC C25804
R6: 100k; R_0603_1608Metric; LCSC C25803
U2: 61CN; SOT-23; LCSC C112138
U3: 74HC4060; TSSOP-16_4.4x5mm_P0.65mm; LCSC C32699

Connections:
GND: C5.2, C7.1, Q2.2 (E), U2.2 (GND), U3.8 (VSS); also elsewhere on the board
NRESET: Q2.3 (C), U2.1 (~RESET)
unnamed: C6.1, C7.2, R4.1, R6.1
unnamed: Q2.1 (B), R3.2
unnamed: R3.1, U3.3 (Q14)
unnamed: C6.2, U3.9 (~Φ0)
unnamed: R4.2, U3.11 (~Φ1)
unnamed: R6.2, U3.10 (Φ0)
V3.3: C5.1, U2.3 (VCC), U3.16 (VDD); also elsewhere on the board
WATCHDOG_RESET: U3.12 (CLR); also elsewhere on the board

Notes on the sheet:
CD4060BM (TI) HEF4060 (Nexperia)
approx. 5 Hz: 1 / (2.2 * R6 * C6) (reset after ~15 minutes)

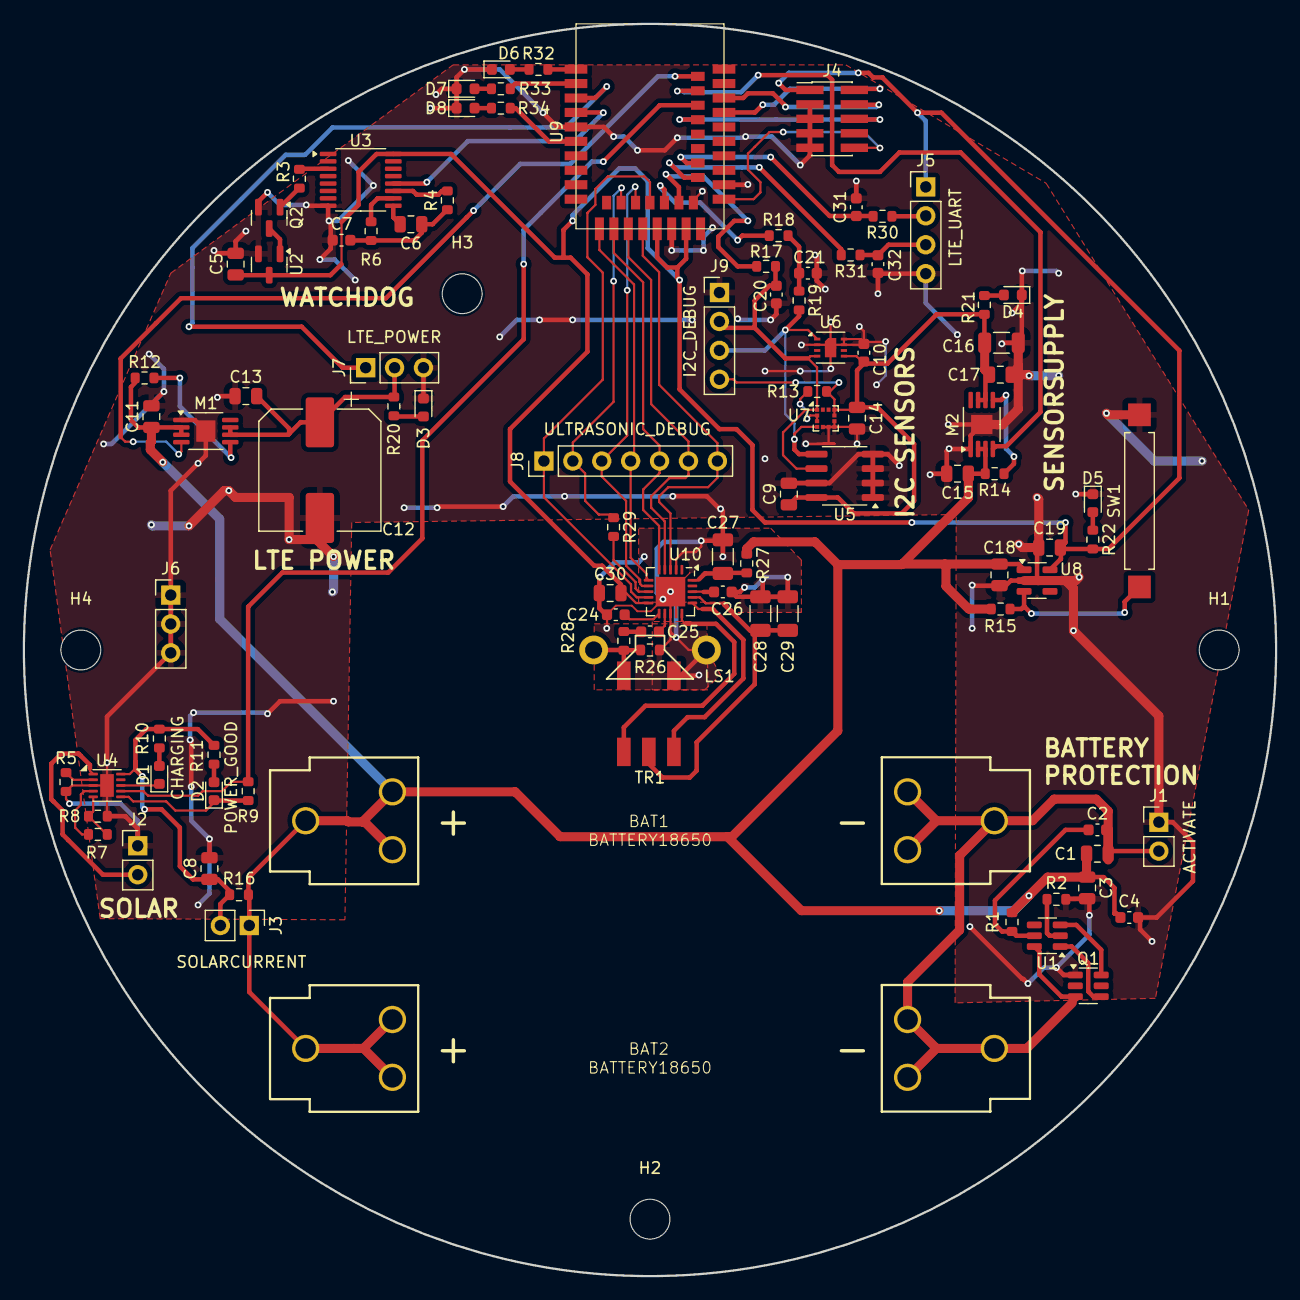
[picture p18: board main-nrf52-e73.kicad_pcb from above]

Board: 2 copper layers, 110.0 x 110.0 mm, 101 parts (0 on the bottom side), 74 nets.
