brickxter/smartersilo.pcb/(commit log)

2024-12-02 main-nrf52-e73: Populated with first schematic.
    PCB routing still pending.
    [battery.kicad_sch, i2c.kicad_sch, main-nrf52-e73.kicad_sch, nrf52-e73.kicad_sch, power.kicad_sch, solar.kicad_sch, ultrasonic.kicad_sch, watchdog.kicad_sch]
2024-12-10 Finished first prototype of nRF52 powered main PCB.
    Using Ebyte E73 module for the nRF chip.
    [20241203-main-nrf52-e73.csv, E73-2G4M08S1C.step, battery.kicad_sch, i2c.kicad_sch, main-nrf52-e73.kicad_pcb, main-nrf52-e73.kicad_sch, nrf52-e73.kicad_sch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]
